truongbui692002/DATN_20232/Ảnh/PCB.png

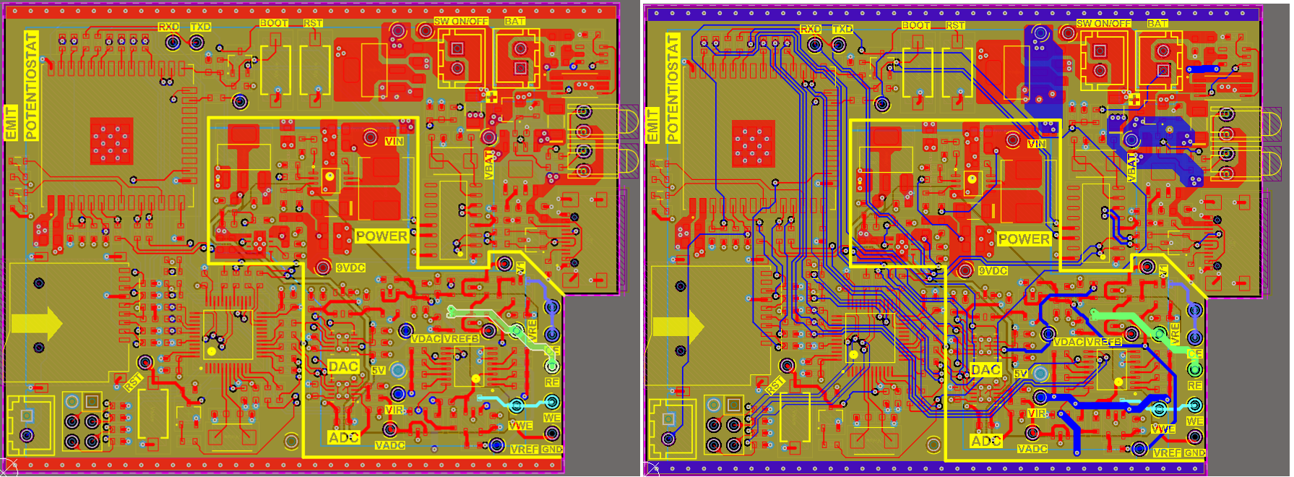
Ảnh/PCB.png
