truongbui692002/DATN_20232/README.md

# ĐATN_20232 Bùi Vũ Duy Trường - HUST - EE2_03
