truongbui692002/DATN_20232/REF/image_2024-02-20_09-43-14.png

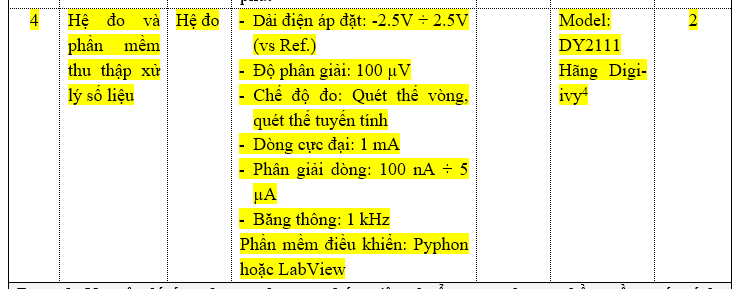
REF/image_2024-02-20_09-43-14.png
