truongbui692002/DATN_20232/Hardware/Potentiostat_Sensor/Project Outputs for Potentiostat_Sensor/Potentiostat_Sensor.xlsx

Designator | Comment | Description | Footprint | Quantity | Type | Link
B100 | Button 3x4x2.5 |  | BUTTON_2P_SMD | 1 | VN
C100, C104, C105, C106, C107, C108, C202, C203, C204, C205, C206, C300, C303, C306, C314 | 100nF | Capacitor | CAP0603-M | 15 | VN
C102, C109 | 0603 | CAP CER 18PF 50V C0G/NP0 0603 | CAP0603-M | 2 | VN
C103, C201, C307 | 10uF | Capacitor, CAP CER 10UF 16V X5R 0603 | CAP0603-M | 3 | VN
C200 | 100nF | Capacitor | C0805 | 1 | VN
C207, C208 | 22pF | Capacitor | CAP0603-M | 2 | VN
C301, C302, C317, C318 | CAP CER 10UF 10V X5R 0402 | 10 µF ±20% 10V Ceramic Capacitor X5R 0402 (1005 Metric) | C0805 | 4 | VN
C304 | 10nF |  | CAP0603-M | 1 | VN
C305 | 22nF |  | CAP0603-M | 1 | VN
C308, C309, C311, C400, C401, C402, C403, C404, C405, C406, C407, C408, C409, C410, C411, C412, C413, C414, C415, C416, C417, C418, C419, C420 | CAP CER 10UF 10V X5R 0402 | 10 µF ±20% 10V Ceramic Capacitor X5R 0402 (1005 Metric) | CAP0603-M | 24 | VN
C310, C312, C313 | CAP CER 10000PF 25V X5R 0201 | 10000 pF ±10% 25V Ceramic Capacitor X5R 0201 (0603 Metric) | CAP0603-M | 3 | VN
C315, C316 | 10uF | CAP CER 10UF 16V X5R 0603 | C0805 | 2 | VN
D100, D200 | RED | LED RED | LED-0603-Red | 2 | VN
D101, D201 | GREEN | LED GREEN | LED-0603-Green | 2 | VN
D103, D104, D105, D106, D202, D203, D204, D205, D206 | ESDAXLC6-1BU2 | TVS DIODE 3VWM 17VC ST0201 | 2-UDFN | 9 | VN
D207 | DESD2CAN2SOQ-7 | TVS DIODE 24VWM 41VC SOT23 | SOT23-3 | 1 | VN
D300 | SS26 | TVS Diode (Uni-directional) | SOD123F | 1 | VN
D301 | GREEN | LED GREEN | LED RIGHT | 1 | VN
D302, D303 | 1N5819 | DIODE ZENER 15V 410MW SOD123 | SOD123F | 2 | VN
D304 | RED | LED RED | LED RIGHT | 1 | VN
ESP200 | Wroom 32D |  | ESP32_UE | 1 | VN
FB300, FB301, FB302 | FerriteBead 220Ohms @100MHz 0201 | 220 Ohms @ 100 MHz 1 Power Line Ferrite Bead 0402 (1005 Metric) 1.5A 95mOhm | INDC1608X80N | 3 | VN
IC300 | TP4056 | Complete single cell Li-Ion battery with a constant current / constant voltage linear charger | TP4056 | 1 | VN
IC301 | DW01A | One Cell Lithium-ion/Polymer Battery Protection IC | SOT23-6 | 1 | VN
IC302 | FS8205A |  | FS8205A | 1 | VN
J200 | CONN RCP USB2.0 TYP C 24P SMD RA | Conn USB Type C RCP 16 POS 0.3mm/0.5mm Solder ST SMD 16 Terminal 1 Port T/R | USB_USB4110-GF-A | 1 | VN
L300 | FIXED IND 4.7UH 1.1A 288MOHM SMD | 4.7 µH Shielded Wirewound Inductor 1.1 A 288mOhm Max 0806 (2016 Metric) | IND25X25CZ | 1 | VN
MODE200 | JP2 | Connector 2 | XH2.54 | 1 | VN
P100 | Header6 |  | XH2.54 2x3 | 1 | VN
Q100, Q200 | MMBT4401 | Transistor C1815, SOT23, NPN 600mW, ECB | SOT23-3 | 2 | VN
Q300 | AO3401A | MOSFET P-CH 30V 4A SOT23-3L | SOT23-3 | 1 | VN
R100, R202, R203, R204, R205, R206, R309 | 10k | Resistor, Resistor 1/4W, RES SMD 10K OHM 1% 1/8W 0805 | R_0603 | 7 | VN
R101, R102, R103, R200, R201, R209, R312 | 1k | RES SMD 10K OHM 1% 1/8W 0805, Resistor, Resistor 1/4W | R_0603 | 7 | VN
R105, R106, R107, R108, R109, R114, R115, R116, R117, R118, R119, R120, R121, R122, R207, R208, R212, R213, R214, R215, R216, R217, R218, R219, R220, R221, R222, R223 | 22R | Resistor 1/4W | R_0603 | 28 | VN
R111, R311, R400, R401, R402, R403, R404, R405, R406, R407, R408, R409, R410, R411, R412, R413, R414, R415, R416, R417 | RES 11.3K OHM 1% 1/20W 0201 | 11.3kOhms ±1% 0.05W, 1/20W Chip Resistor 0201 (0603 Metric) Moisture Resistant Thick Film | R_0603 | 20 | VN
R210, R211 | 5.1kR | Resistor 1/4W | R_0603 | 2 | VN
R300, R302, R305, R306, R307 | RES 100K OHM 1/20W 5% 0201 SMD | 100 kOhms ±1% 0.05W, 1/20W Chip Resistor 0201 (0603 Metric) Moisture Resistant Thick Film | R_0603 | 5 | VN
R301, R303, R304, R308 | 1k2 | RES SMD 10K OHM 1% 1/8W 0805 | R_0603 | 4 | VN
R310 | 10R | Resistor SMD | R_0603 | 1 | VN
R313 | 30k | RES SMD 10K OHM 1% 1/8W 0805 | R_0603 | 1 | VN
R314 | RES 10K OHM 1% 1/20W 0201 | 10 kOhms ±1% 0.05W, 1/20W Chip Resistor 0201 (0603 Metric) Moisture Resistant Thick Film | R_0603 | 1 | VN
R315 | 100k | RES SMD 10K OHM 1% 1/8W 0805 | R_0603 | 1 | VN
S200, S201 | SW | Switch button 2 pin | BUTTON_2P_SMD | 2 | VN
SW301, SW302 | SWITCH ON/OFF | Connector 2 | XH2.54 | 2 | VN
U100 | STM32F103C8T6 | IC MCU 48LQFP | LQFP48 | 1 | VN
U200 | CH340G | USB to UART Interface | SOIC-16 | 1 | VN
U201 | SD_CARD | SD/MMC holder | MICROSD2 | 1 | VN
U300 | MP1542 |  | TSOP65P490X95-8N | 5 | DIGIKEY | https://www.digikey.com/en/products/detail/monolithic-power-systems-inc/MP1542DK-LF-Z/5291722
U301 | TPS7A4901DRBT | IC REG LINEAR POS ADJ 150MA 8SON | IC_DRV8601DRBT | 5 | DIGIKEY | https://www.digikey.com/en/products/detail/texas-instruments/TPS7A4901DRBT/6110565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
U302, U407 | LM1117-3.3 | IC REG LINEAR 3.3V 1A SOT223 | SOT223-4 | 2 | VN
U400 | AD5541ABCPZ-REEL7 | IC DAC 16BIT V-OUT 10LFCSP | SON50P300X300X80-11N | 5 | DIGIKEY | https://www.digikey.com/en/products/detail/analog-devices-inc/AD5541ABCPZ-REEL7/2606737
U401, U402, U403, U404, U409, U410 | AD8605ARTZ-REEL7 | IC OPAMP GP 1 CIRCUIT SOT23-5 | SOT95P280X145-5N | 25 | DIGIKEY | https://www.digikey.com/en/products/detail/analog-devices-inc/AD8605ARTZ-REEL/654063
U405 | LT6654AIS6-2.5#TRMPBF | IC VREF SERIES 0.05% TSOT23-6 | SOT95P280X145-6N | 5 | DIGIKEY | https://www.digikey.com/en/products/detail/analog-devices-inc/LT6654AIS6-2-5-TRMPBF/7322679
U406 | MAX4617CUE+T | IC MUX 8:1 10OHM 16TSSOP | TSOP65P640X110-16N | 5 | DIGIKEY | https://www.digikey.com/en/products/detail/analog-devices-inc-maxim-integrated/MAX4617CUE-T/1781481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
U408 | AD4008BCPZ-RL7 | IC ADC 16BIT SAR 10LFCSP | PSON50P300X80_HS-11N | 5 | DIGIKEY | https://www.digikey.com/en/products/detail/analog-devices-inc/AD4008BCPZ-RL7/7914791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
X100, X200 | WTL5G60391VH | XTal 8Mhz | XTAL_SMD_3P5 | 2
