truongbui692002/DATN_20232/Firmware/Potentio_ESP/build/bootloader-prefix/src/bootloader-stamp/bootloader-source_dirinfo.txt

# This is a generated file and its contents are an internal implementation detail.
# The download step will be re-executed if anything in this file changes.
# No other meaning or use of this file is supported.

method=source_dir
command=
source_dir=D:/ESP_IDF_V5_1/Espressif/frameworks/esp-idf-v5.1/components/bootloader/subproject
work_dir=
