truongbui692002/DATN_20232/(threads)

Thread 1 (2024-07-04):

ADC_Pin

truongbui692002, 2024-07-04:
Read ADC for pin Lithium got 1 issue, it can not run program
