truongbui692002/DATN_20232/Hardware/Potentiostat_Sensor/Project Outputs for Potentiostat_Sensor/Potentiostat_Sensor.PDF

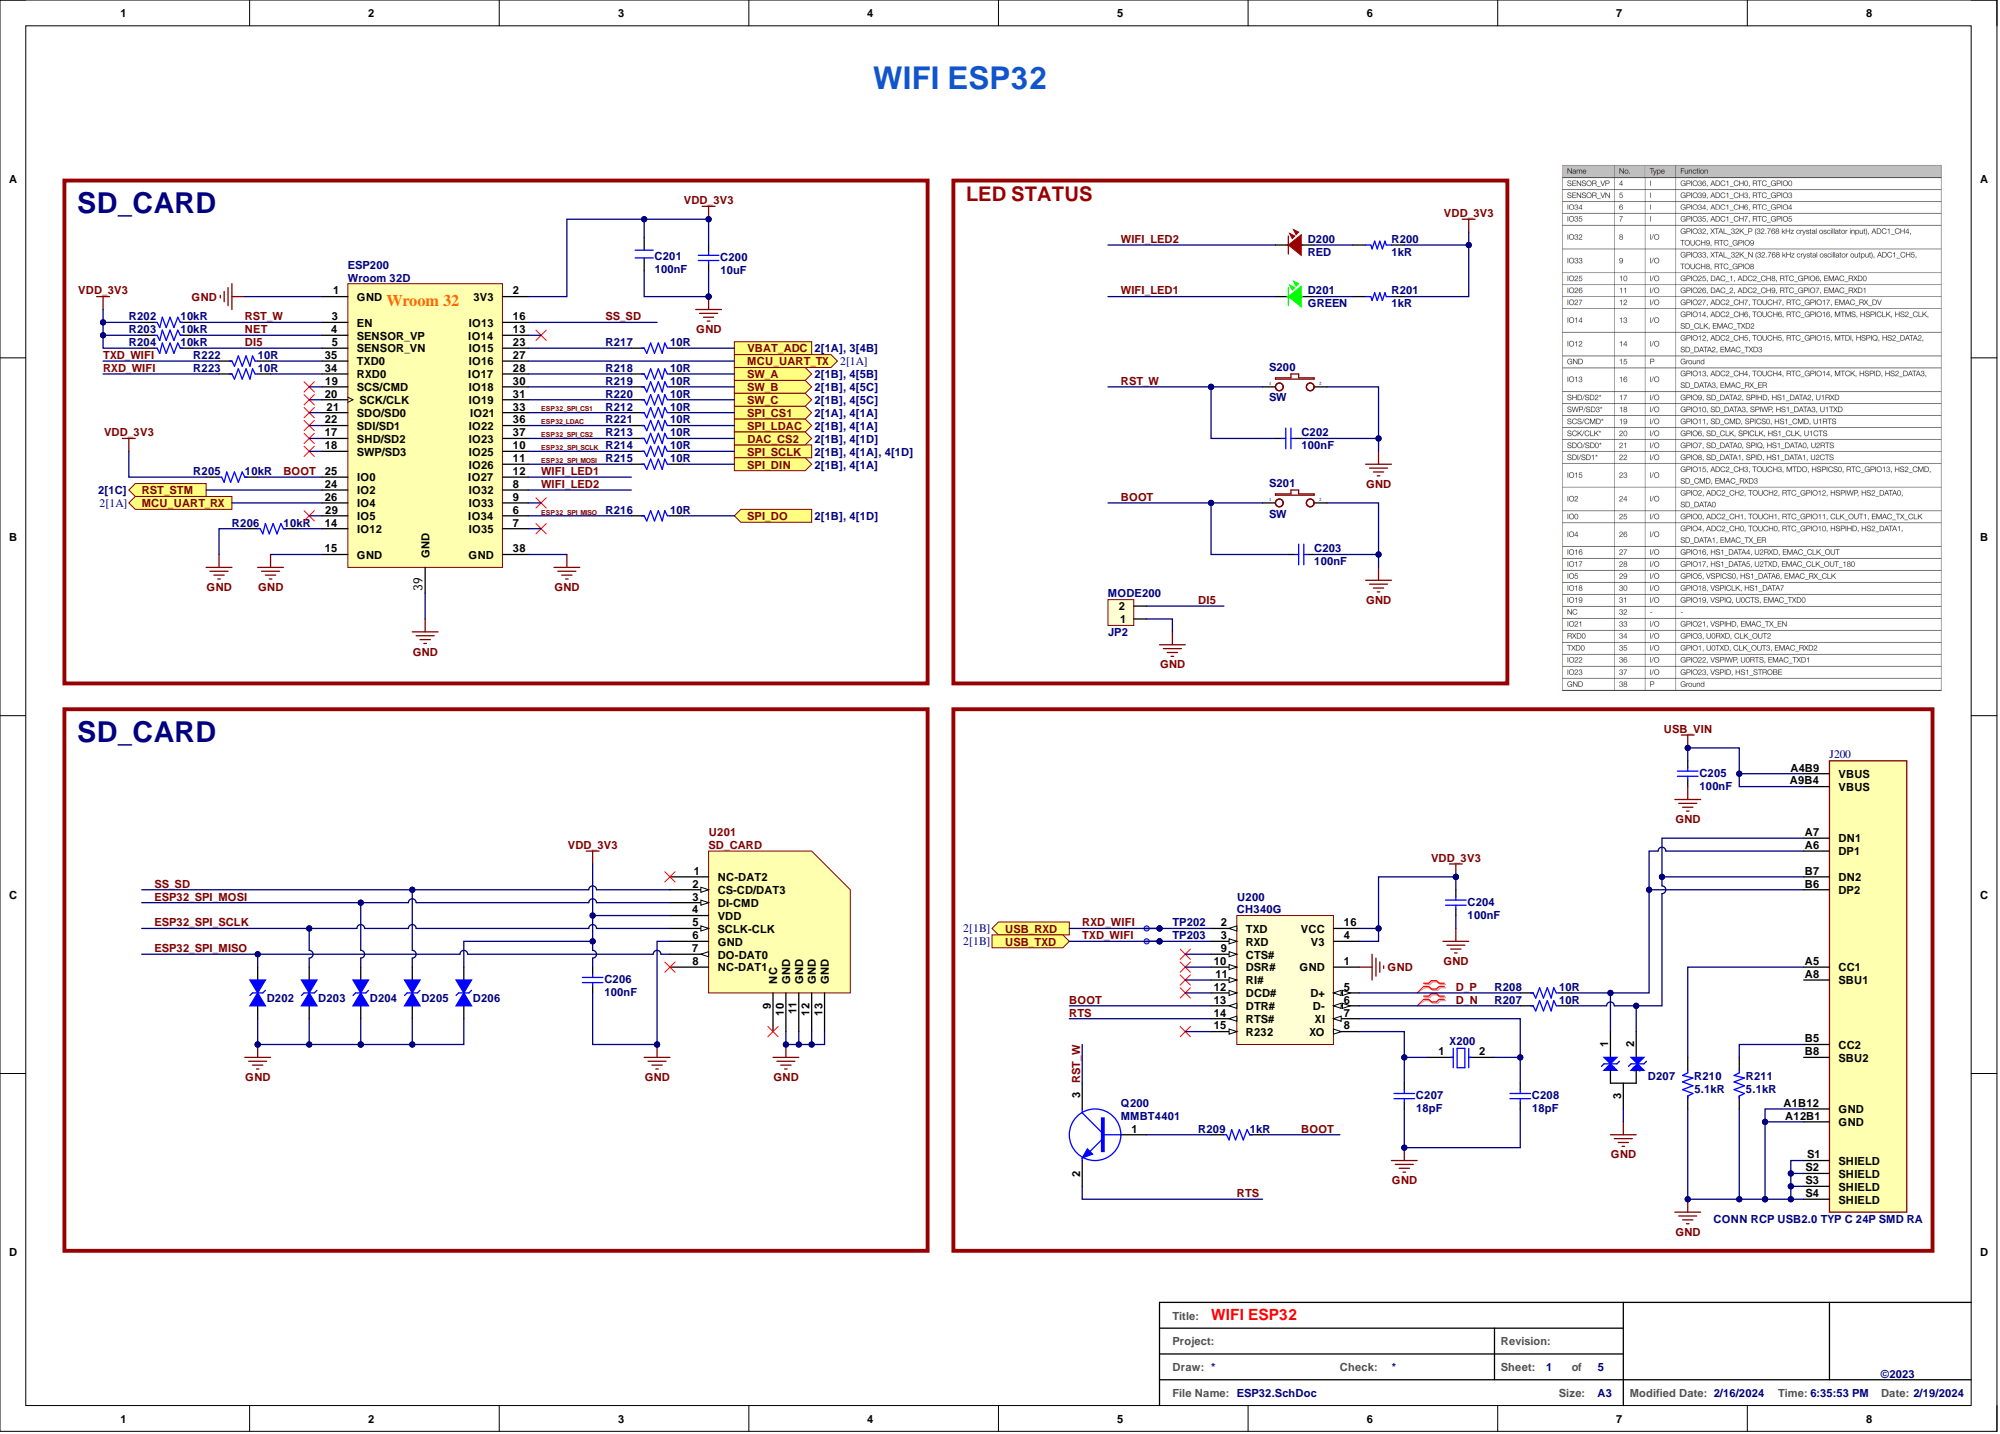
[picture p112: page 1]

GND A12B1

SHIELD S1
SHIELD S2
SHIELD S3

CONN RCP USB2.0 TYP C 24P SMD RA

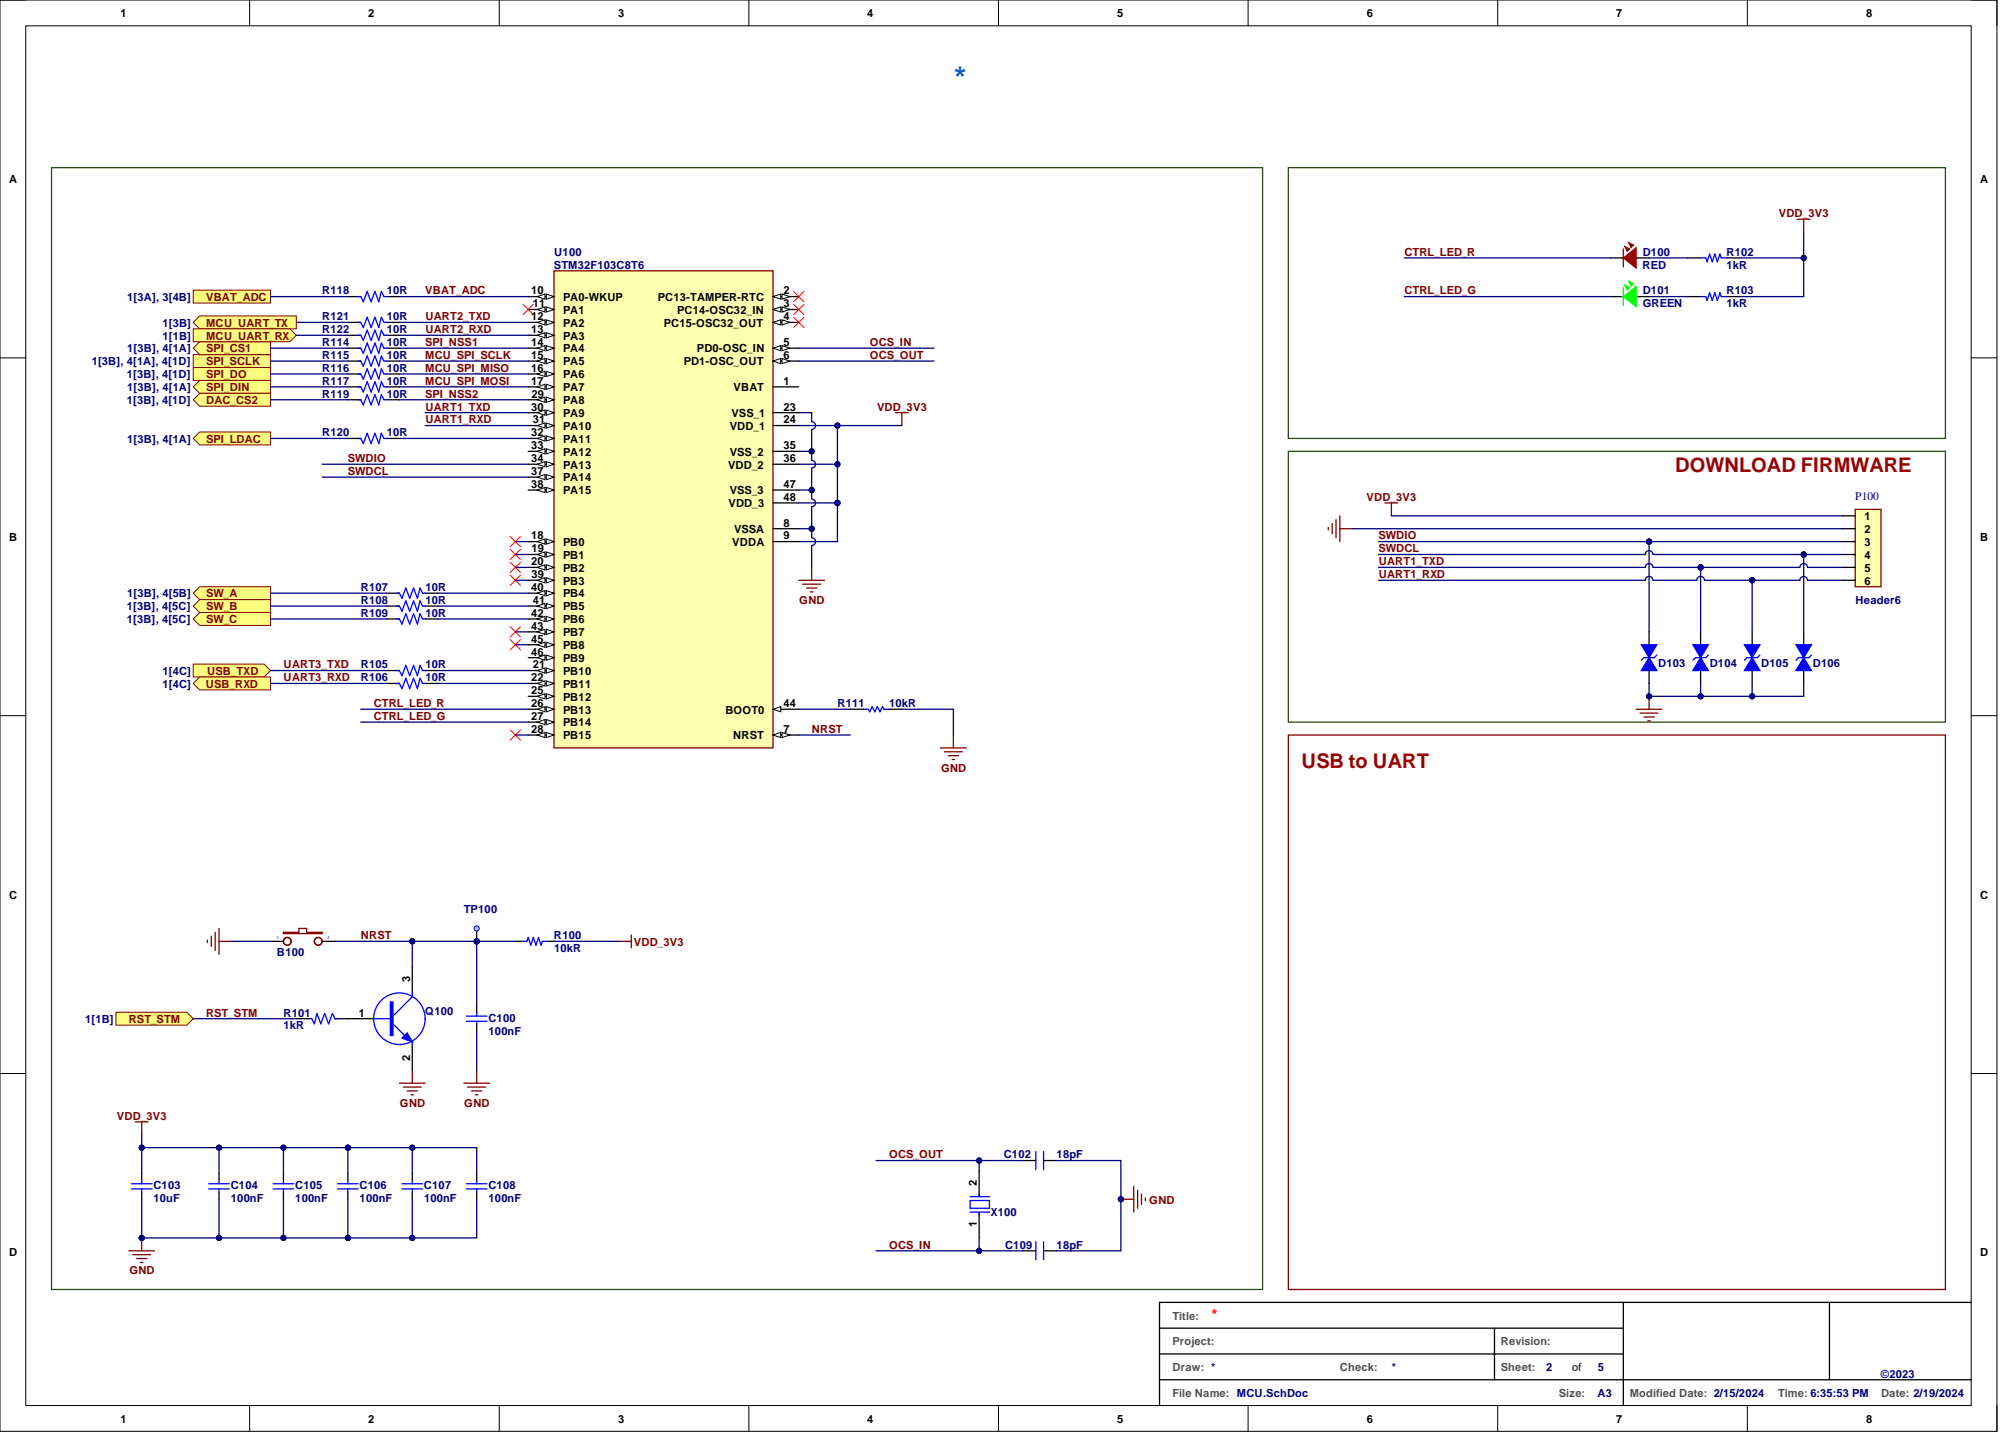
[picture p113: page 2]

35 6 VSS_2

47 8 VSS_3

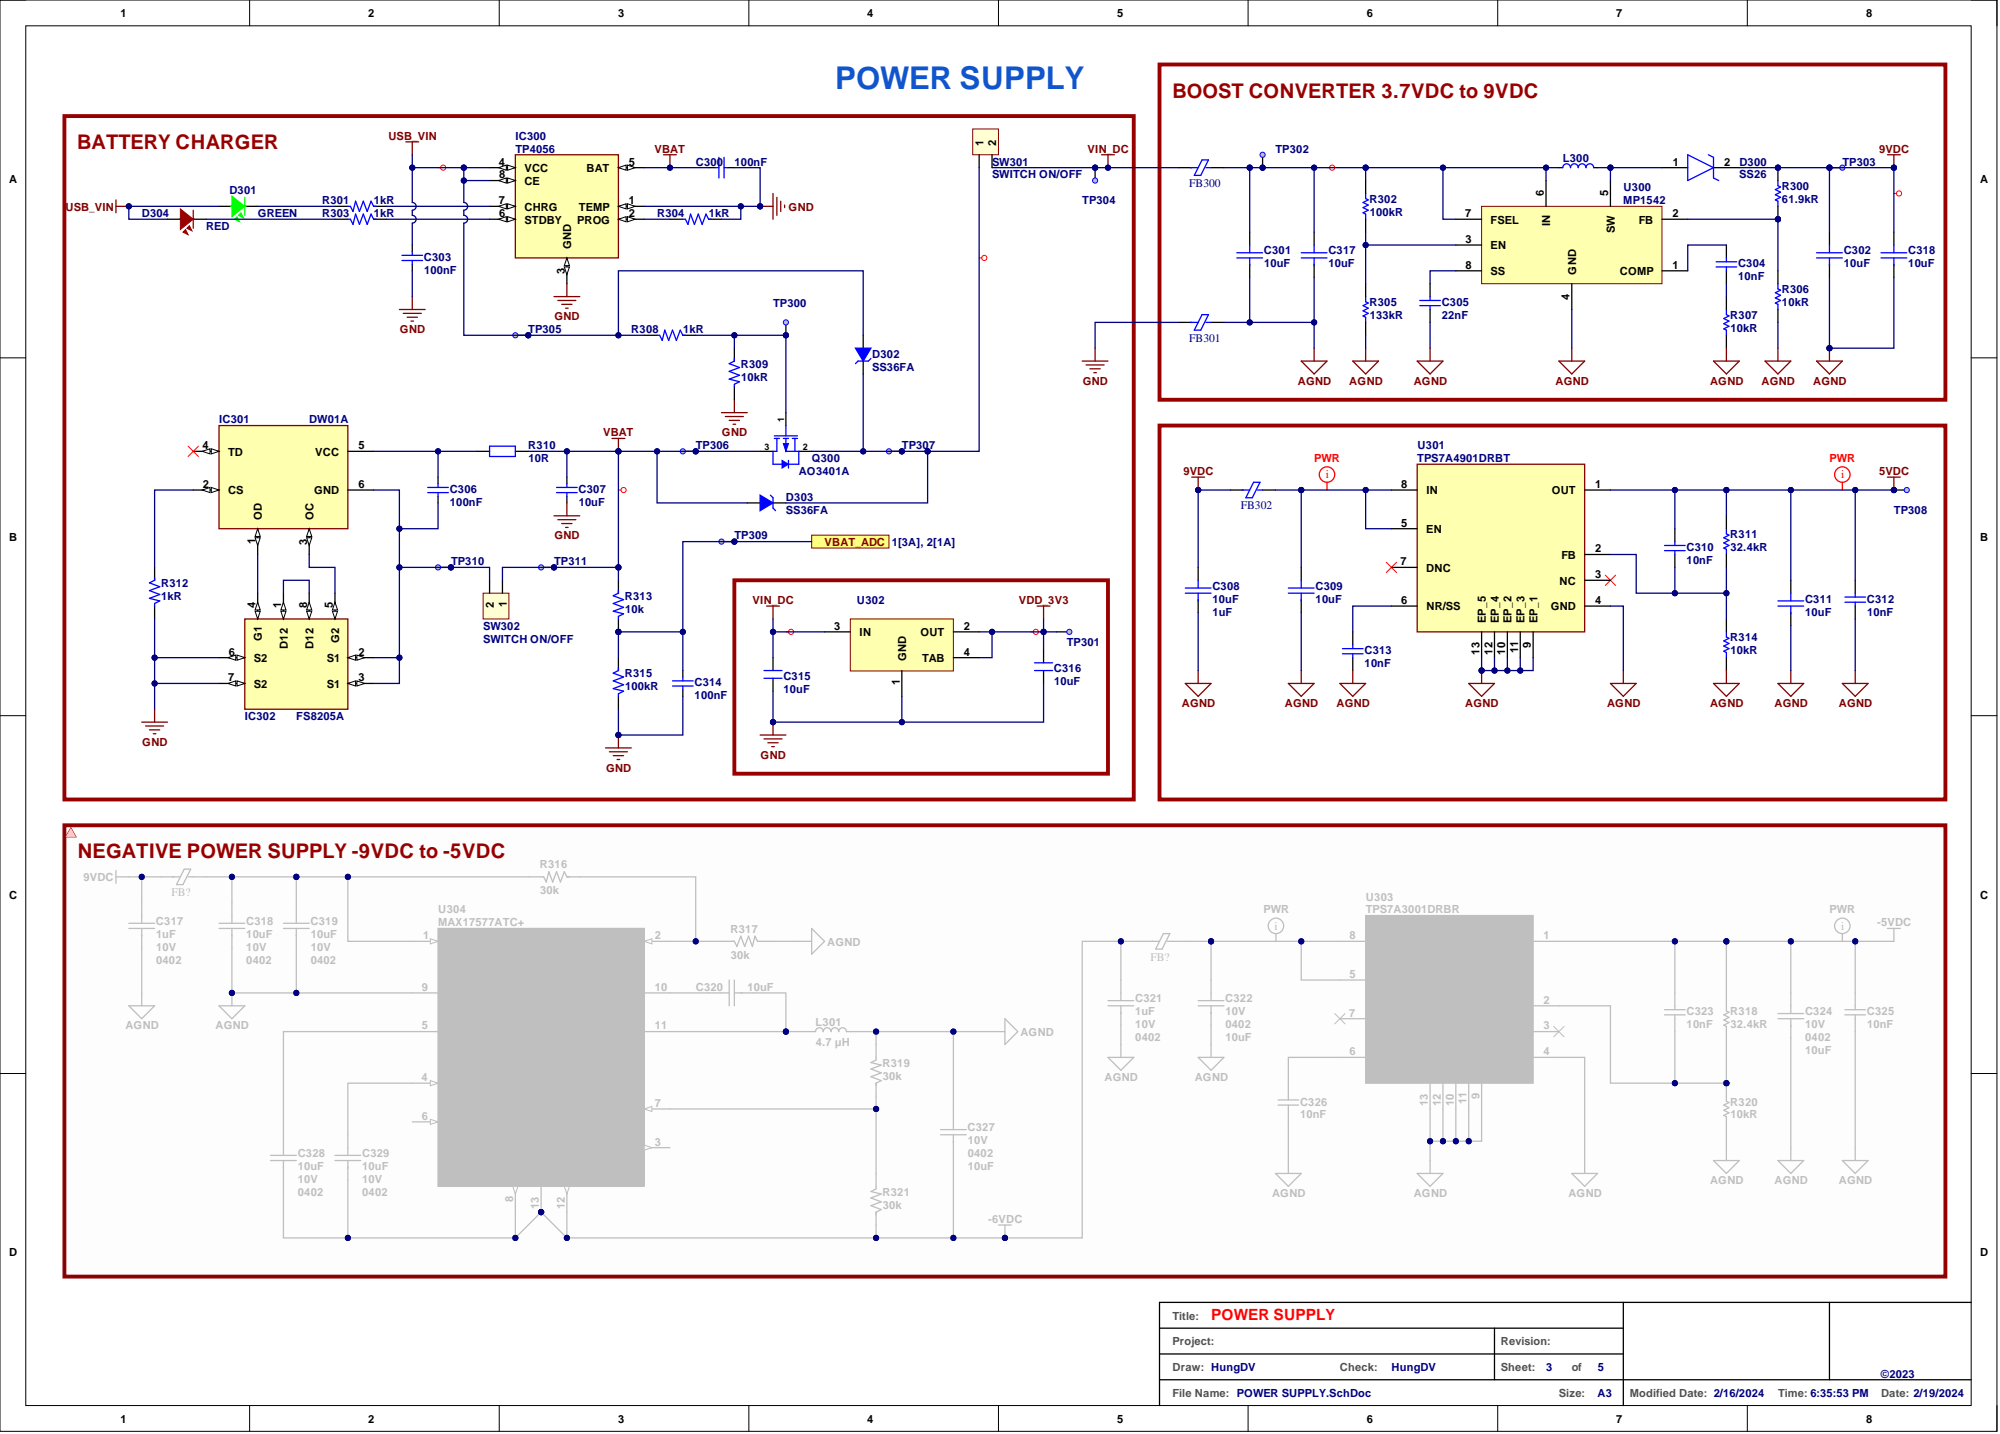
[picture p114: page 3]

NEGATIVE POWER SUPPLY -9VDC to -5VDC

VCC 5

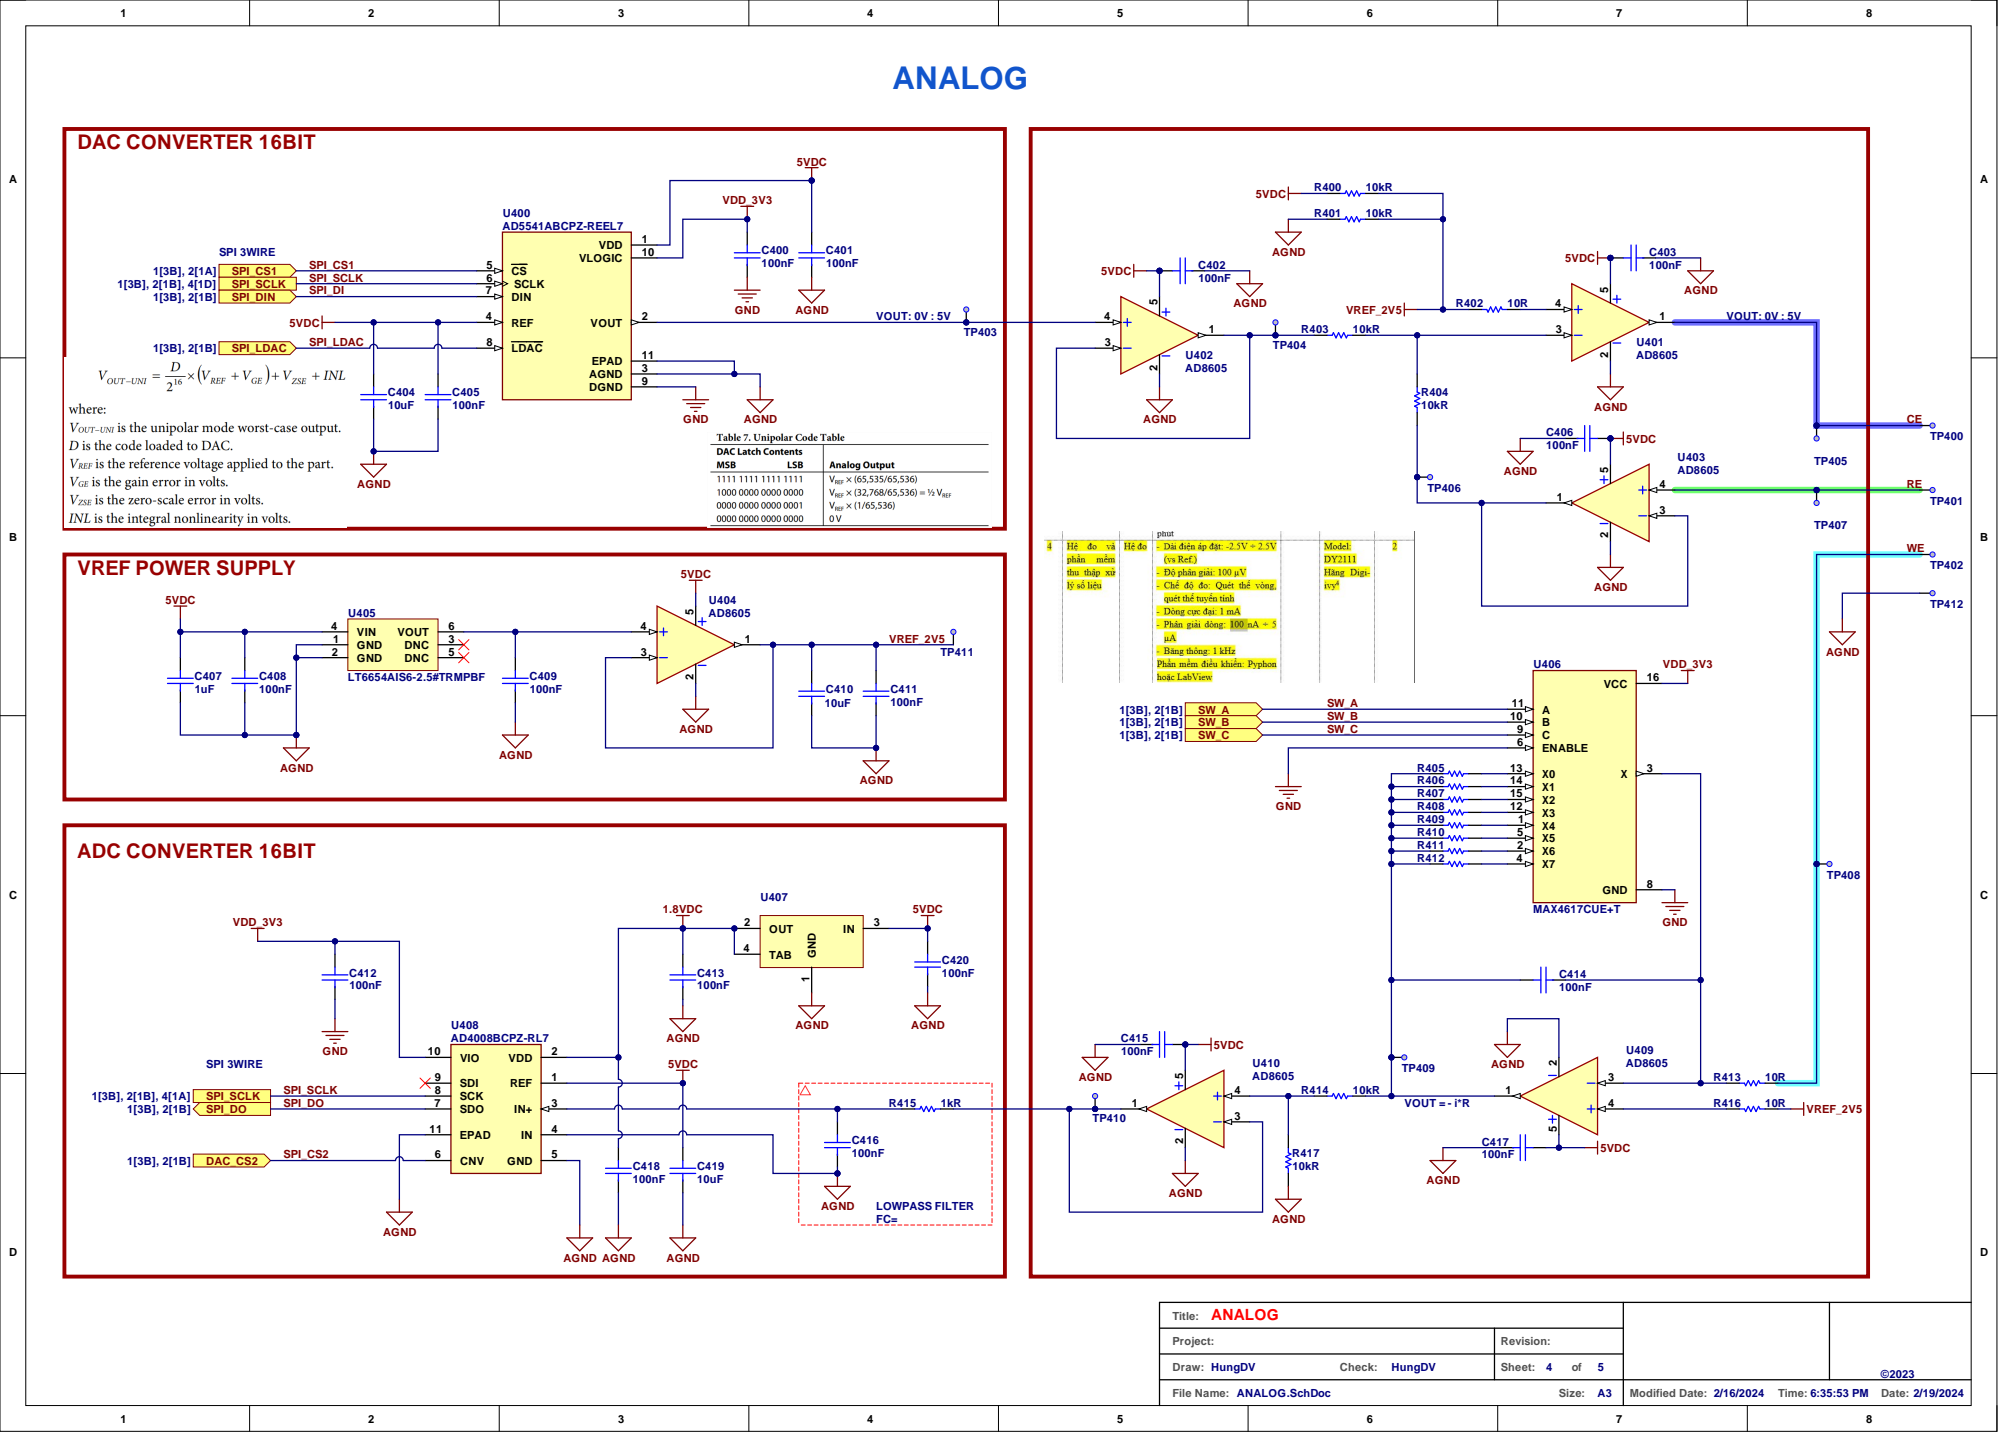
[picture p115: page 4]

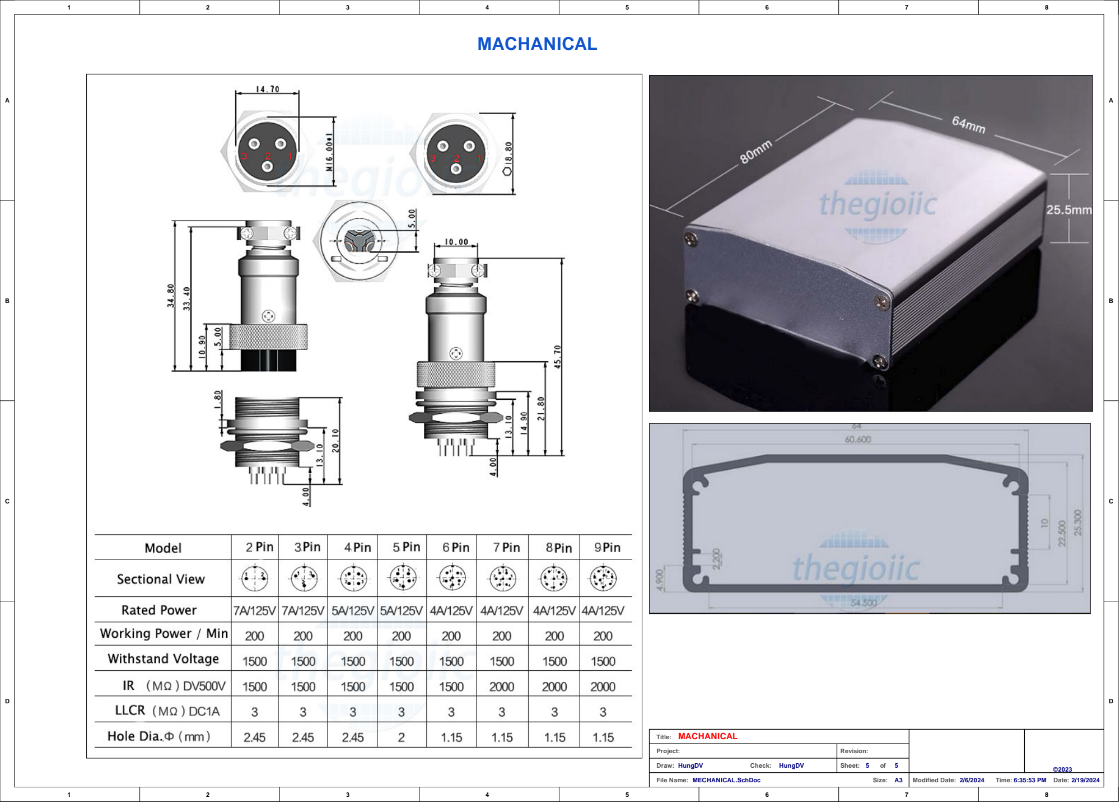
[picture p116: page 5]

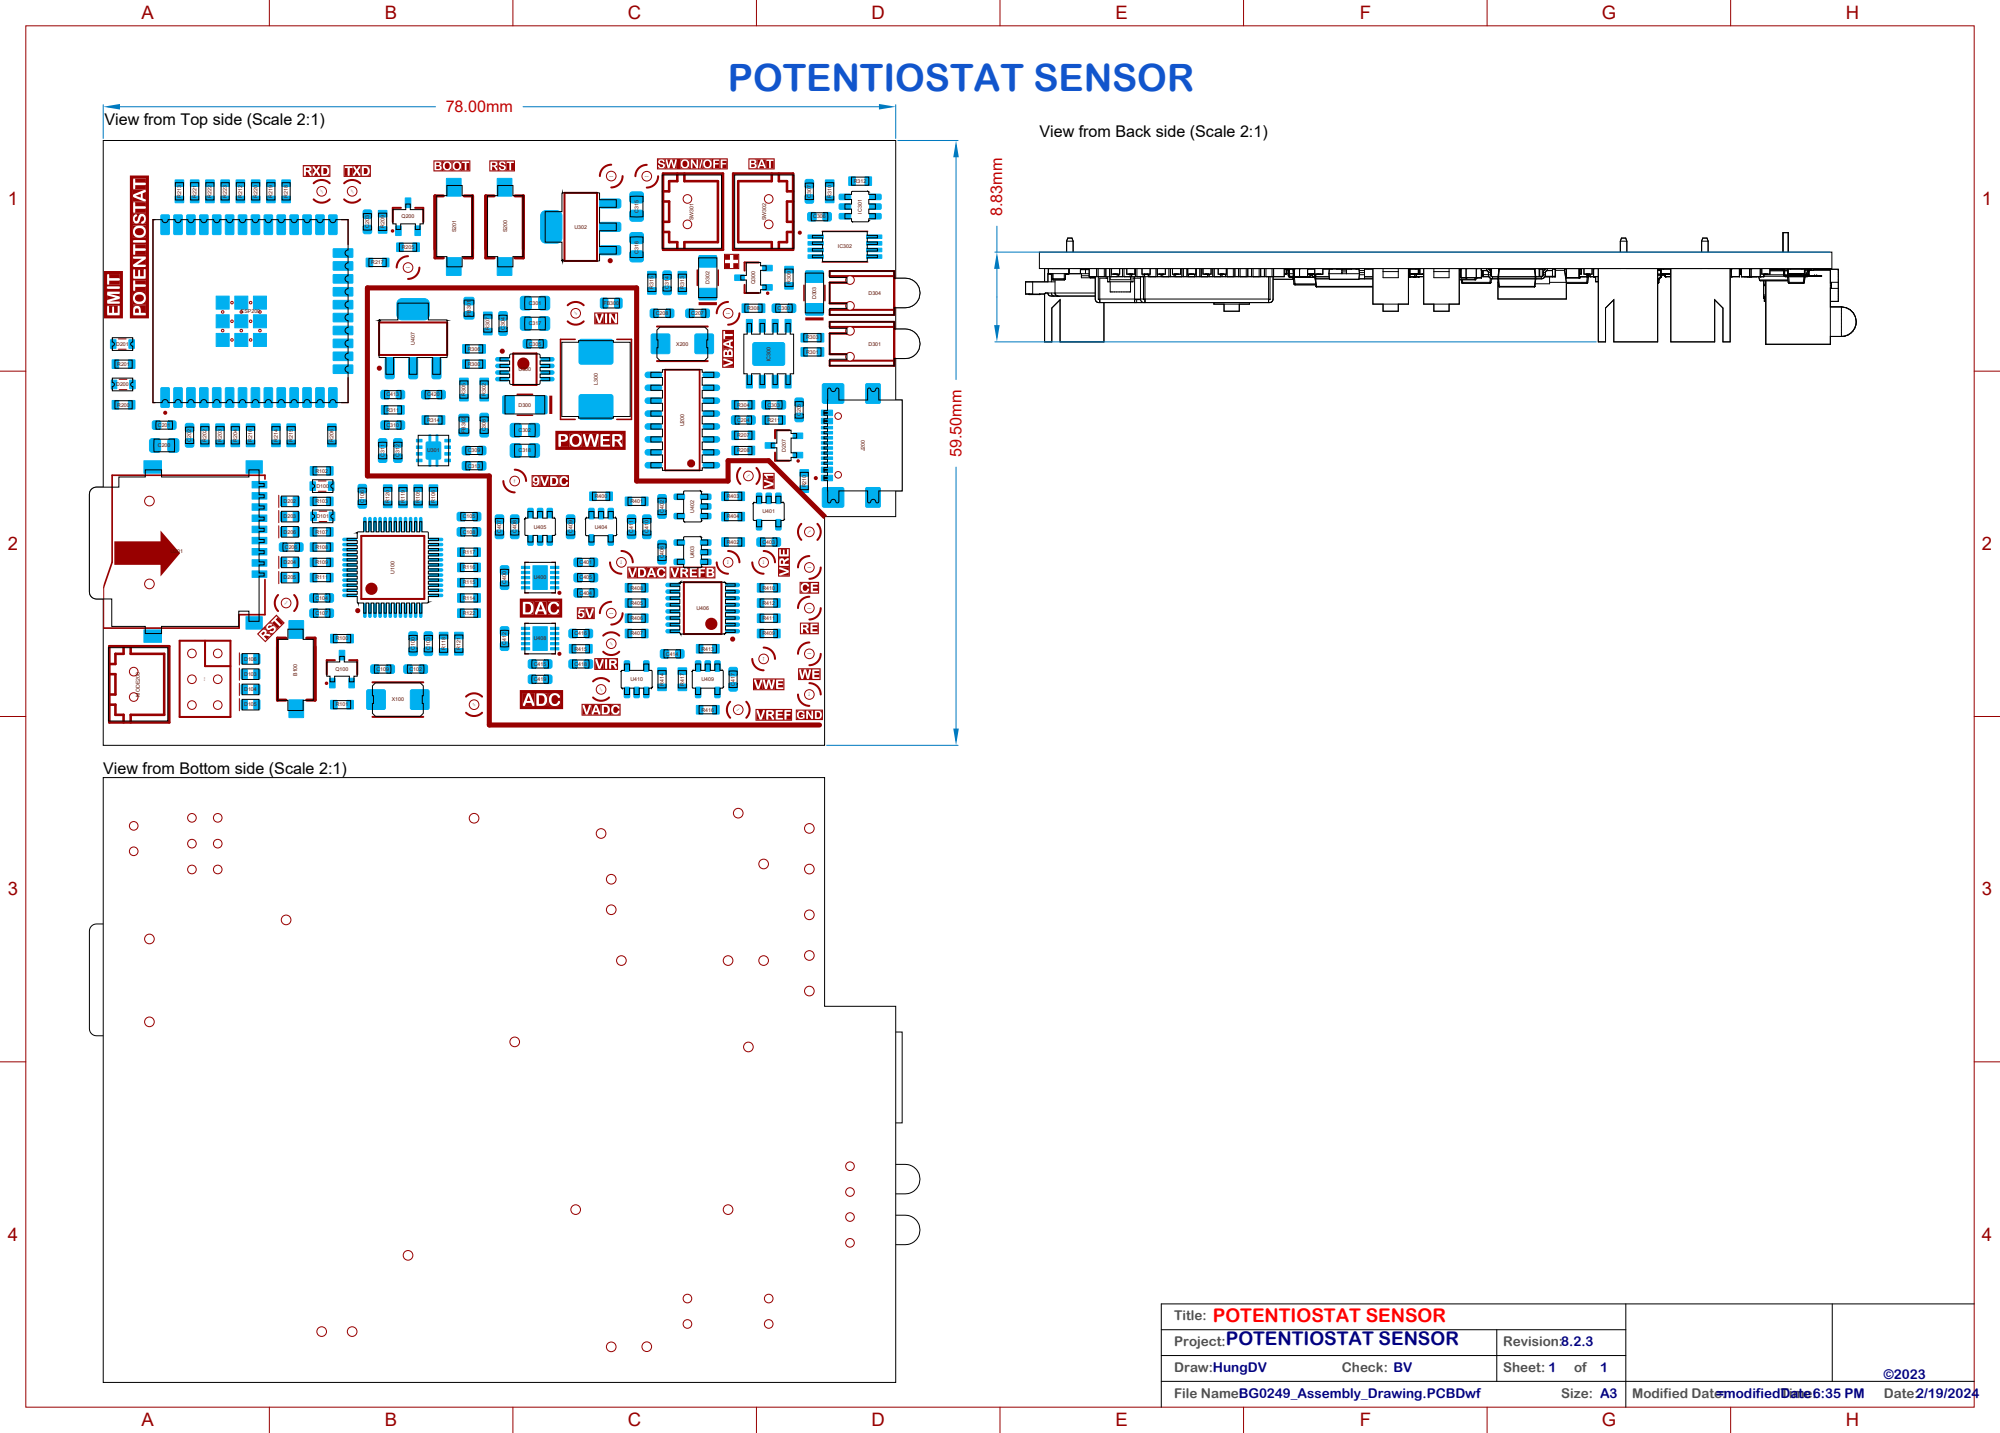
[picture p117: page 6]

View from Top side (Scale 2:1)

View from Back side (Scale 2:1)

View from Bottom side (Scale 2:1)
