truongbui692002/DATN_20232/(list of files, drawings)

Other design files:
DATN_20202543/Hardware/Potentiostat_Sensor/ANALOG.SchDoc
DATN_20202543/Hardware/Potentiostat_Sensor/ESP32.SchDoc
DATN_20202543/Hardware/Potentiostat_Sensor/MCU.SchDoc
DATN_20202543/Hardware/Potentiostat_Sensor/MECHANICAL.SchDoc
DATN_20202543/Hardware/Potentiostat_Sensor/PCB Panel.PcbDoc
DATN_20202543/Hardware/Potentiostat_Sensor/Potentiostat_Sensor.PrjPcb
DATN_20202543/Hardware/Potentiostat_Sensor/POWER SUPPLY.SchDoc
