truongbui692002/DATN_20232/DATN_20202543/Firmware/firmware/Core/Src/main.c

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
/* Includes ------------------------------------------------------------------*/
#include "main.h"

/* USER CODE BEGIN Includes */
#include "log.h"
#include "stimer.h"
#include "common_user.h"
/* USER CODE END Includes */

ADC_HandleTypeDef hadc1;

SPI_HandleTypeDef hspi1;

UART_HandleTypeDef huart1;
UART_HandleTypeDef huart2;
DMA_HandleTypeDef hdma_usart2_rx;

/* USER CODE BEGIN PV */
extern DAC_DeviceTypes_t dev1;
extern ADC_DeviceTypes_t dev2;

extern char txBuffer[512];
extern char rxBuffer[512];

extern systemHandle_t systemHandle;
extern deviceInfo_obj_t deviceInfo_t;
configInfo_obj_t configInfo_t = {0};

measureData_t measureData = {0};
double collect_volt = 0;
uint16_t adc_value = 0;
uint16_t adc_value1 = 0;
volatile uint8_t scan_direction = 1; // 1 for forward, 0 for reverse
volatile uint8_t current_cycle = 0;
double Vref = 5.12;

uint16_t adc_pin_value = 0;
float volt_pin = 0;

/* USER CODE END PV */

void SystemClock_Config(void);
static void MX_GPIO_Init(void);
static void MX_DMA_Init(void);
static void MX_USART2_UART_Init(void);
static void MX_ADC1_Init(void);
static void MX_SPI1_Init(void);
static void MX_USART1_UART_Init(void);
/* USER CODE BEGIN PFP */
extern void appMeasureInit(void);
extern void Config_dev(configInfo_obj_t *configInfo_t);
/* USER CODE END PFP */

/* USER CODE BEGIN 0 */
#ifdef __GNUC__
int __io_putchar(int ch)
#else
int fputc(int ch, FILE *f)
#endif /* __GNUC__ */
{
  HAL_UART_Transmit(&huart1, (uint8_t *)&ch, 1, 1);
  return ch;
}

/* USER CODE END 0 */

/**
  * @brief  The application entry point.
  * @retval int
  */
int main(void)
{
  /* MCU Configuration--------------------------------------------------------*/

  /* Reset of all peripherals, Initializes the Flash interface and the Systick. */
  HAL_Init();

  /* Configure the system clock */
  SystemClock_Config();

  /* Initialize all configured peripherals */
  MX_GPIO_Init();
  MX_DMA_Init();
  MX_USART2_UART_Init();
  MX_ADC1_Init();
  MX_SPI1_Init();
  MX_USART1_UART_Init();
  /* USER CODE BEGIN 2 */
  appMeasureInit();

  Logi("START DEVICE");

  /* USER CODE END 2 */

  /* Infinite loop */
  /* USER CODE BEGIN WHILE */
  while (1)
  {
    /* USER CODE END WHILE */

    /* USER CODE BEGIN 3 */
	  if(systemHandle.devCfg == true){

		  HAL_GPIO_TogglePin(LED_G_GPIO_Port, LED_G_Pin);
		  HAL_GPIO_WritePin(LED_R_GPIO_Port, LED_R_Pin, 1);
		  HAL_ADC_Start(&hadc1);
		  HAL_ADC_PollForConversion(&hadc1, 1000);
		  adc_pin_value = HAL_ADC_GetValue(&hadc1);
		  volt_pin = 4.0/3*(3.3*adc_pin_value)/4095;
		  HAL_ADC_Stop(&hadc1);
		  // Logic cho chế độ quét CV
		  if (deviceInfo_t.mode_dev == 2) {
		  	// Logic cho chế độ quét CV

		  	// Gửi điện áp đến DAC
		  	AD5441A_SetVotage(&dev1, 2.5 - deviceInfo_t.current_volt + 0.2);
		  	measureData.potential = deviceInfo_t.current_volt*1000;
		  	HAL_Delay(125);
		  	adc_value = AD4008_single_conversion(&dev2, adc_value);

		  	// Chuyển đổi giá trị ADC sang giá trị áp dụng(V)
		  	collect_volt = (adc_value*Vref / 65536);

		  	if(deviceInfo_t.res_dev == 1){
		  		measureData.current = (2.5-collect_volt)*1000.0/1500.0;
		  	} else if (deviceInfo_t.res_dev == 2) {
		  		measureData.current = (2.5-collect_volt)*1000000.0/14600.0;
		  	} else if (deviceInfo_t.res_dev == 3) {
		  		measureData.current = (2.5-collect_volt)*1000000000/2000000.0;
		  	}
		  	// �?i�?u chỉnh điện áp cho bước tiếp theo
		  	if (scan_direction == 1) {
		  		deviceInfo_t.current_volt += deviceInfo_t.step_volt;
		  		if (deviceInfo_t.current_volt > deviceInfo_t.target_volt - 0.0001) {
		  			scan_direction = 0; // �?ảo chi�?u quét
		  		}
		  	} else if(scan_direction == 0){
		  			deviceInfo_t.current_volt -= deviceInfo_t.step_volt;
		  			if (deviceInfo_t.current_volt < deviceInfo_t.start_volt + 0.0001) {
		  				scan_direction = 1; // �?ảo chi�?u quét
		  				current_cycle++;
		  					if (current_cycle >= deviceInfo_t.num_cycle) {
								// �?ã hoàn thành tất cả các chu kỳ, dừng Timer
								systemHandle.devCfg = false;
								systemHandle.startDev = false;
								configInfo_t.config_done = false;
								current_cycle =0;
		  					}
		  				}
		  			}
		 }

		  // Logic cho chế độ quét LSV
		  else if (deviceInfo_t.mode_dev == 1) {
			  // Logic cho chế độ quét LSV

			  // Gửi điện áp đến DAC
			  AD5441A_SetVotage(&dev1, 2.5 - deviceInfo_t.current_volt + 0.2);
			  measureData.potential = deviceInfo_t.current_volt*1000;
			  HAL_Delay(125);
			  adc_value = AD4008_single_conversion(&dev2, adc_value);

			  // Chuyển đổi giá trị ADC sang giá trị áp dụng(V)
			  collect_volt = (adc_value*Vref / 65536);

			  if(deviceInfo_t.res_dev == 1){
				  measureData.current = (2.5-collect_volt)*1000.0/1500.0;
			  } else if (deviceInfo_t.res_dev == 2) {
				  measureData.current = (2.5-collect_volt)*1000000.0/14600.0;
			  } else if (deviceInfo_t.res_dev == 3) {
				  measureData.current = (2.5-collect_volt)*1000000000/2000000.0;
			  }
			  // Tăng điện áp
			  deviceInfo_t.current_volt += deviceInfo_t.step_volt;
			  if (deviceInfo_t.current_volt > deviceInfo_t.target_volt*1.0001) {
				  // �?ã đạt điện thế kết thúc, dừng quét
				  systemHandle.devCfg = false;
				  configInfo_t.config_done = false;
				  systemHandle.startDev = false;
				  current_cycle = 0;
			  }

		  }
		  sprintf(txBuffer, "{\"start\":%d,\"potential\":%d,\"current\":%d}", systemHandle.startDev, (int)round(measureData.potential),(int)round(measureData.current*100));
//		  Logi("%s", txBuffer);
		  Logi("VRE-VWE:%.3f - Current:%.5f - VOLT_ADC:%.5f - VOLT_PIN:%d", measureData.potential, measureData.current,collect_volt,adc_pin_value);
		  HAL_UART_Transmit(&huart2, (uint8_t *)txBuffer, strlen(txBuffer), 1000);
		  HAL_Delay(875);
	  }
	  else {
			adc_value1 = AD4008_single_conversion(&dev2, adc_value1);
//			Logi("VRE-VWE:%.3f - Current:%.5f - VOLT_ADC:%.5f", measureData.potential, (2.5 - (adc_value1*Vref / 65536))*1000000.0/14600.0,collect_volt);
		  	HAL_GPIO_WritePin(LED_G_GPIO_Port, LED_G_Pin, 1);
		  	HAL_GPIO_WritePin(LED_R_GPIO_Port, LED_R_Pin, 0);
		#ifndef TEST
		  	HAL_Delay(150);
			HAL_UART_Transmit(&huart2, (uint8_t *)("$"), 1, 1000);
			HAL_UARTEx_ReceiveToIdle_DMA(&huart2, (uint8_t *)rxBuffer, sizeof(rxBuffer));
			__HAL_DMA_DISABLE_IT(&hdma_usart2_rx, DMA_IT_HT);
		  while(!(systemHandle.devCfg == true))
		  {

			  if (systemHandle.rxBufAvai == true)
			  {
				  if (!strcmp(rxBuffer, "GATT_Connected"))
					{
						Logi("%s", rxBuffer);
						memset(rxBuffer, 0 , sizeof(rxBuffer));
					}
				  else if (strstr(rxBuffer , "{") != NULL) {
						configInfo_t.config_done = false;
						Logi("%s", rxBuffer);
						uart_parse_data(rxBuffer, &configInfo_t);
						Config_dev(&configInfo_t);
						memset(rxBuffer, 0 , sizeof(rxBuffer));
					}
				  else if (strstr(rxBuffer, "Start_device") != NULL)
				  {
					  if(configInfo_t.config_done == true){
						  systemHandle.devCfg = true;
						  systemHandle.startDev = true;
					  }

					  Logi("%s", rxBuffer);
					  Logi("Start %s Scan", configInfo_t.mode_device);

				  }
				  memset(rxBuffer, 0 , sizeof(rxBuffer));
				  HAL_UARTEx_ReceiveToIdle_DMA(&huart2, (uint8_t *)rxBuffer, sizeof(rxBuffer));
				  __HAL_DMA_DISABLE_IT(&hdma_usart2_rx, DMA_IT_HT);
				  systemHandle.rxBufAvai = false;
			  }
		  }
		  memset(rxBuffer, 0 , sizeof(rxBuffer));
		  HAL_UARTEx_ReceiveToIdle_DMA(&huart2, (uint8_t *)rxBuffer, sizeof(rxBuffer));
		  __HAL_DMA_DISABLE_IT(&hdma_usart2_rx, DMA_IT_HT);
		#endif
	  }
}
  /* USER CODE END 3 */
}

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
