truongbui692002/DATN_20232/DATN_20202543/Firmware/firmware/Core/Inc/main.h

#define VBAT_ADC_Pin GPIO_PIN_0
#define VBAT_ADC_GPIO_Port GPIOA
#define DAC_CS_Pin GPIO_PIN_4
#define DAC_CS_GPIO_Port GPIOA
#define LED_R_Pin GPIO_PIN_13
#define LED_R_GPIO_Port GPIOB
#define LED_G_Pin GPIO_PIN_14
#define LED_G_GPIO_Port GPIOB
#define ADC_CS_Pin GPIO_PIN_8
#define ADC_CS_GPIO_Port GPIOA
#define LDAC_Pin GPIO_PIN_11
#define LDAC_GPIO_Port GPIOA
#define SW_A_Pin GPIO_PIN_4
#define SW_A_GPIO_Port GPIOB
#define SW_B_Pin GPIO_PIN_5
#define SW_B_GPIO_Port GPIOB
#define SW_C_Pin GPIO_PIN_6
#define SW_C_GPIO_Port GPIOB
