truongbui692002/DATN_20232/DATN_20202543/Firmware/Potentio_ESP/main/logo.h

#ifndef _LOGO_H_
#define _LOGO_H_

#define LOGO        "========================================================= \r\n" \                                                    
                    " _______   __    __  ____    ____ .___________..______       __    __    ______   .__   __.   _______      \r\n" \ 
                    "|       \\ |  |  |  | \\   \\  /   / |           ||   _  \\     |  |  |  |  /  __  \\  |  \\ |  |  /  _____|     \r\n" \ 
                    "|  .--.  ||  |  |  |  \\   \\/   /  `---|  |----`|  |_)  |    |  |  |  | |  |  |  | |   \\|  | |  |  __       \r\n" \ 
                    "|  |  |  ||  |  |  |   \\_    _/       |  |     |      /     |  |  |  | |  |  |  | |  . `  | |  | |_ |      \r\n" \ 
                    "|  '--'  ||  `--'  |     |  |         |  |     |  |\\  \\----.|  `--'  | |  `--'  | |  |\\   | |  |__| |      \r\n" \ 
                    "|_______/  \\______/      |__|         |__|     | _| `._____| \\______/   \\______/  |__| \\__|  \\______|      \r\n" \                                                                                                                                                                                                                                                                                                               
                    "========================================================= \r\n" 



 
                                                                                                      
#define Poten_LOGO  "========================================================= \r\n" \
                    ".______     ______   .___________. _______ .__   __. .___________. __    ______        _______.___________.    ___   .___________.     \r\n" \
                    "|   _  \\  /  __   \\ |            ||   ____||  \\ |  | |           ||  |  /  __  \\      /       |           |   /   \\  |           |     \r\n" \
                    "|  |_)  | |  |  |  | `---|  |----`|  |__   |   \\|  | `---|  |----`|  | |  |  |  |    |   (----`---|  |----`  /  ^  \\ `---|  |----`     \r\n" \
                    "|   ___/  |  |  |  |     |  |     |   __|  |  . `  |     |  |     |  | |  |  |  |     \\   \\       |  |      /  /_\\  \\    |  |          \r\n" \
                    "|  |      |  `--'  |     |  |     |  |____ |  |\\   |     |  |     |  | |  `--'  | .----)   |      |  |     /  _____  \\   |  |          \r\n" \
                    "| _|       \\______/      |__|     |_______||__| \\__|     |__|     |__|  \\______/  |_______/       |__|    /__/     \\__\\  |__|          \r\n" \                                                                                                                                                                                                                                                                                                                         
                    "========================================================= \r\n" 


#endif
