truongbui692002/DATN_20232/DATN_20202543/Firmware/Potentio_ESP/main/adc.c

#include "adc.h"

static const char *TAG = "ADC";

static int adc_raw[2][10];
int voltage_bat[2][10];

/*---------------------------------------------------------------
        ADC Calibration
---------------------------------------------------------------*/
static bool adc_calibration_init(adc_unit_t unit, adc_atten_t atten, adc_cali_handle_t *out_handle)
{
    adc_cali_handle_t handle = NULL;
    esp_err_t ret = ESP_FAIL;
    bool calibrated = false;

#if ADC_CALI_SCHEME_LINE_FITTING_SUPPORTED
    if (!calibrated) {
        ESP_LOGI(TAG, "calibration scheme version is %s", "Line Fitting");
        adc_cali_line_fitting_config_t cali_config = {
            .unit_id = unit,
            .atten = atten,
            .bitwidth = ADC_BITWIDTH_DEFAULT,
        };
        ret = adc_cali_create_scheme_line_fitting(&cali_config, &handle);
        if (ret == ESP_OK) {
            calibrated = true;
        }
    }
#endif

    *out_handle = handle;
    if (ret == ESP_OK) {
        ESP_LOGI(TAG, "Calibration Success");
    } else if (ret == ESP_ERR_NOT_SUPPORTED || !calibrated) {
        ESP_LOGW(TAG, "eFuse not burnt, skip software calibration");
    } else {
        ESP_LOGE(TAG, "Invalid arg or no memory");
    }

    return calibrated;
}

static void adc_calibration_deinit(adc_cali_handle_t handle)
{
#if ADC_CALI_SCHEME_LINE_FITTING_SUPPORTED
    ESP_LOGI(TAG, "deregister %s calibration scheme", "Line Fitting");
    ESP_ERROR_CHECK(adc_cali_delete_scheme_line_fitting(handle));
#endif
}

void adc_task(void *param)
{
    //-------------ADC2 Init---------------//
    adc_oneshot_unit_handle_t adc2_handle;
    adc_oneshot_unit_init_cfg_t init_config2 = {
        .unit_id = ADC2_UNIT,
        .ulp_mode = ADC_ULP_MODE_DISABLE,
    };
    ESP_ERROR_CHECK(adc_oneshot_new_unit(&init_config2, &adc2_handle));

    //-------------ADC2 Calibration Init---------------//
    adc_cali_handle_t adc2_cali_handle = NULL;
    bool do_calibration2 = adc_calibration_init(ADC2_UNIT, ADC_ATTEN, &adc2_cali_handle);

    //-------------ADC2 Config---------------//
    adc_oneshot_chan_cfg_t config = {
        .bitwidth = ADC_BIT_WIDTH,
        .atten = ADC_ATTEN,
    };
    ESP_ERROR_CHECK(adc_oneshot_config_channel(adc2_handle, ADC2_CHAN3, &config));

    while (1)
    {
        ESP_ERROR_CHECK(adc_oneshot_read(adc2_handle, ADC2_CHAN3, &adc_raw[1][0]));
        // ESP_LOGI(TAG, "ADC%d Channel[%d] Raw Data: %d", ADC2_UNIT + 1, ADC2_CHAN3, adc_raw[1][0]);
        if (do_calibration2) {
            ESP_ERROR_CHECK(adc_cali_raw_to_voltage(adc2_cali_handle, adc_raw[1][0], &voltage_bat[1][0]));
            ESP_LOGI(TAG, "ADC%d Channel[%d] Cali Voltage: %d mV", ADC2_UNIT + 1, ADC2_CHAN3, voltage_bat[1][0]);
        }
        vTaskDelay(pdMS_TO_TICKS(1000));
    }
    ESP_ERROR_CHECK(adc_oneshot_del_unit(adc2_handle));
    if (do_calibration2) {
        adc_calibration_deinit(adc2_cali_handle);
    }
}
