truongbui692002/DATN_20232/DATN_20202543/Firmware/Potentio_ESP/main/app_ble.h

#ifndef _APP_BLE_H_
#define _APP_BLE_H_
#include "header.h"
#include "common_user.h"

#define GATT_TAG "GATTS_DEMO"

#define GATTS_SERVICE_UUID_TEST_A   0x00FF
#define GATTS_CHAR_UUID_TEST_A      0xFF01
#define GATTS_DESCR_UUID_TEST_A     0x3333
#define GATTS_NUM_HANDLE_TEST_A     4

#define GATTS_SERVICE_UUID_TEST_B   0x00EE
#define GATTS_CHAR_UUID_TEST_B      0xEE01
#define GATTS_DESCR_UUID_TEST_B     0x2222
#define GATTS_NUM_HANDLE_TEST_B     4



#define PROFILE_NUM 2
#define PROFILE_A_APP_ID 0
#define PROFILE_B_APP_ID 1

#define TEST_DEVICE_NAME             "PotentioStat"
#define TEST_MANUFACTURER_DATA_LEN  17

#define GATTS_DEMO_CHAR_VAL_LEN_MAX 0x40

#define PREPARE_BUF_MAX_SIZE 1024

#define adv_config_flag      (1 << 0)
#define scan_rsp_config_flag (1 << 1)

typedef struct {
    uint8_t                 *prepare_buf;
    int                     prepare_len;
} prepare_type_env_t;

struct gatts_profile_inst {
    esp_gatts_cb_t gatts_cb;
    uint16_t gatts_if;
    uint16_t app_id;
    uint16_t conn_id;
    uint16_t service_handle;
    esp_gatt_srvc_id_t service_id;
    uint16_t char_handle;
    esp_bt_uuid_t char_uuid;
    esp_gatt_perm_t perm;
    esp_gatt_char_prop_t property;
    uint16_t descr_handle;
    esp_bt_uuid_t descr_uuid;
};

void ble_init(void);
// int get_sizedata_recv(char msg_recv);

#endif
