truongbui692002/DATN_20232/(commit log)

2024-05-03 Cập nhật Biểu đồ không có tiêu đề.drawio
2024-05-04 Đã thêm Sơ đồ thiết kế.drawio
2024-05-04 Cập nhật Sơ đồ thiết kế.drawio
2024-05-05 Đã thêm Sơ đồ khối nguồn.drawio
2024-05-05 Cập nhật Sơ đồ khối nguồn.drawio
2024-06-08 Đã thêm Sơ đồ thuật toán STM32.drawio
2024-06-08 Cập nhật Sơ đồ thuật toán STM32.drawio
2024-06-08 Đã thêm Lưu đồ thuật toán ESP32.drawio
2024-06-08 Cập nhật Lưu đồ thuật toán ESP32.drawio
2024-06-09 Đã thêm Lưu đồ thuật toán của phần mềm Android.drawio
2024-06-09 Cập nhật Lưu đồ thuật toán của phần mềm Android.drawio
2024-06-13 add hardware
    [ANALOG.SchDoc, ESP32.SchDoc, MCU.SchDoc, MECHANICAL.SchDoc, PCB Panel.PcbDoc, POWER SUPPLY.SchDoc, Potentiostat_Sensor.PrjPcb, Potentiostat_Sensor.xlsx]
2024-06-22 STM32 V1.0 done
