truongbui692002/DATN_20232/(notices)

Notices in the files:
DATN_20202543/Firmware/firmware/Core/Src/main.c:
Copyright (c) 2024 STMicroelectronics.
All rights reserved.
This software is licensed under terms that can be found in the LICENSE file
